ThunderSloth/kirb-3/doc/src/fig/ping_timing_diagram.png

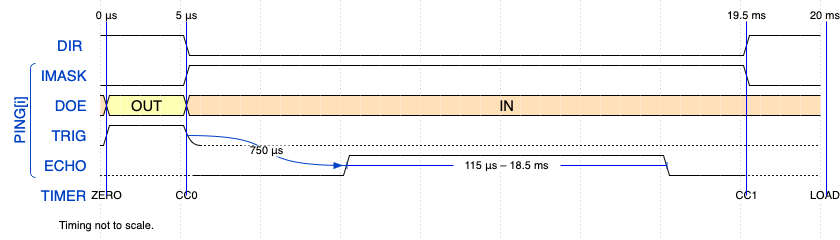
doc/src/fig/ping_timing_diagram.png
