ThunderSloth/kirb-3/resources/FS-iA6B_RC-Receiver_Specs.png

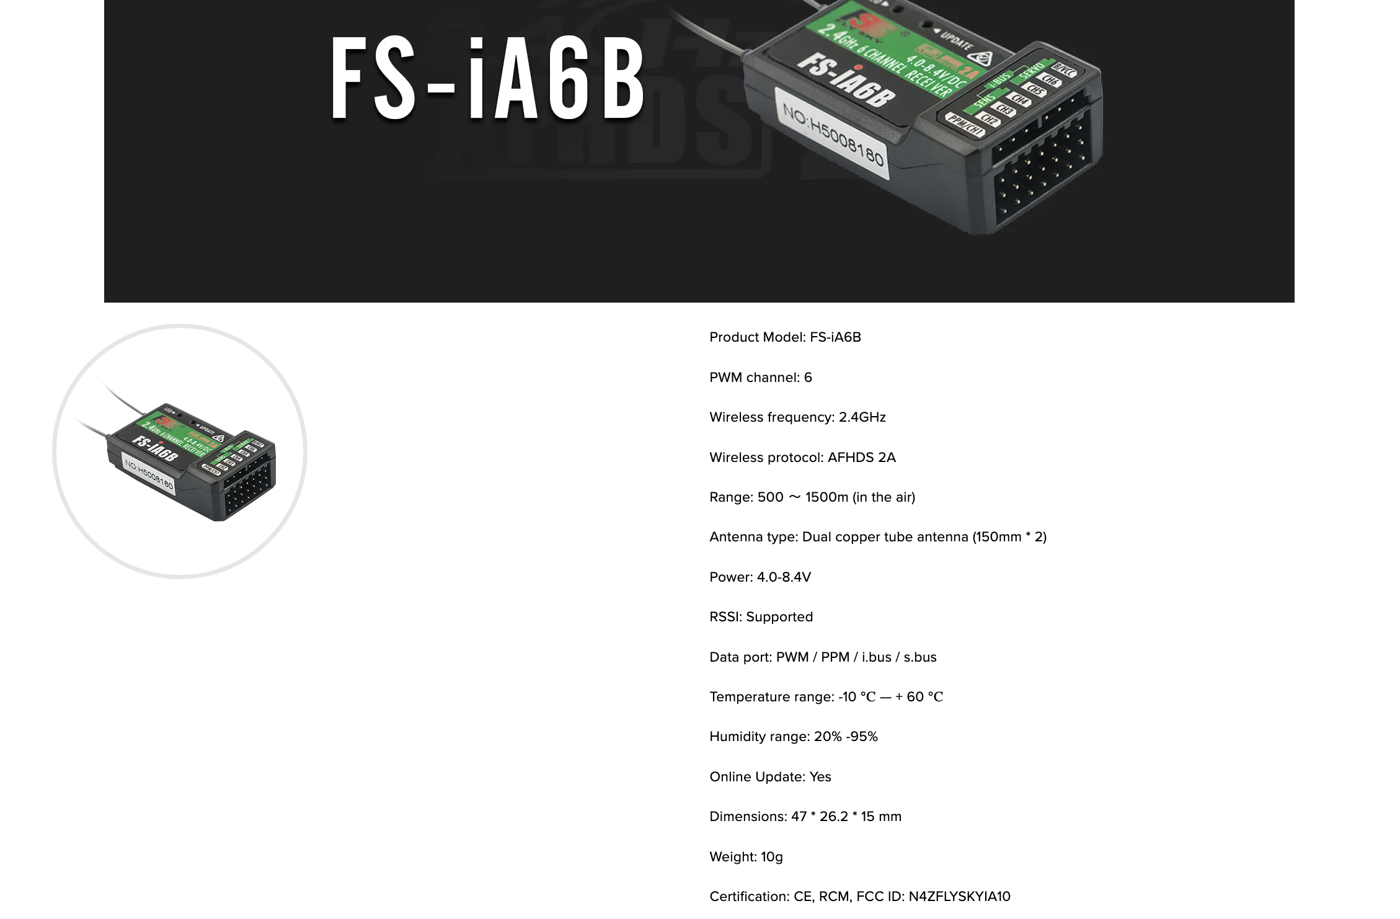
resources/FS-iA6B_RC-Receiver_Specs.png
