ThunderSloth/kirb-3/design/CameraMast.stl

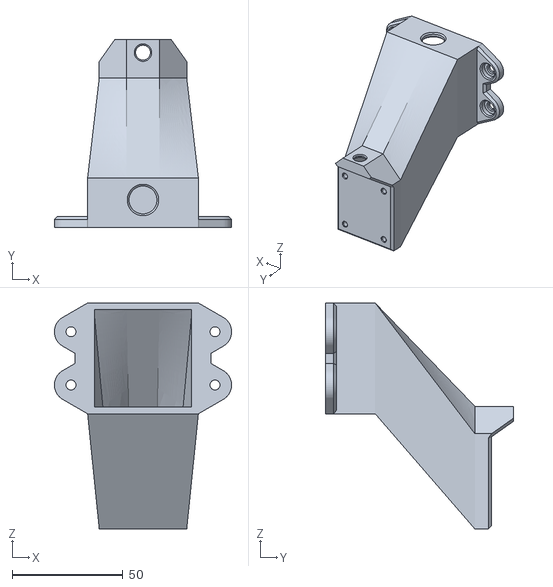
[picture p4: CAD file, 2026-05-11]
design/CameraMast.stl
80.0 x 85.0 x 102.0
