ThunderSloth/kirb-3/resources/QEI_Schematic.pdf

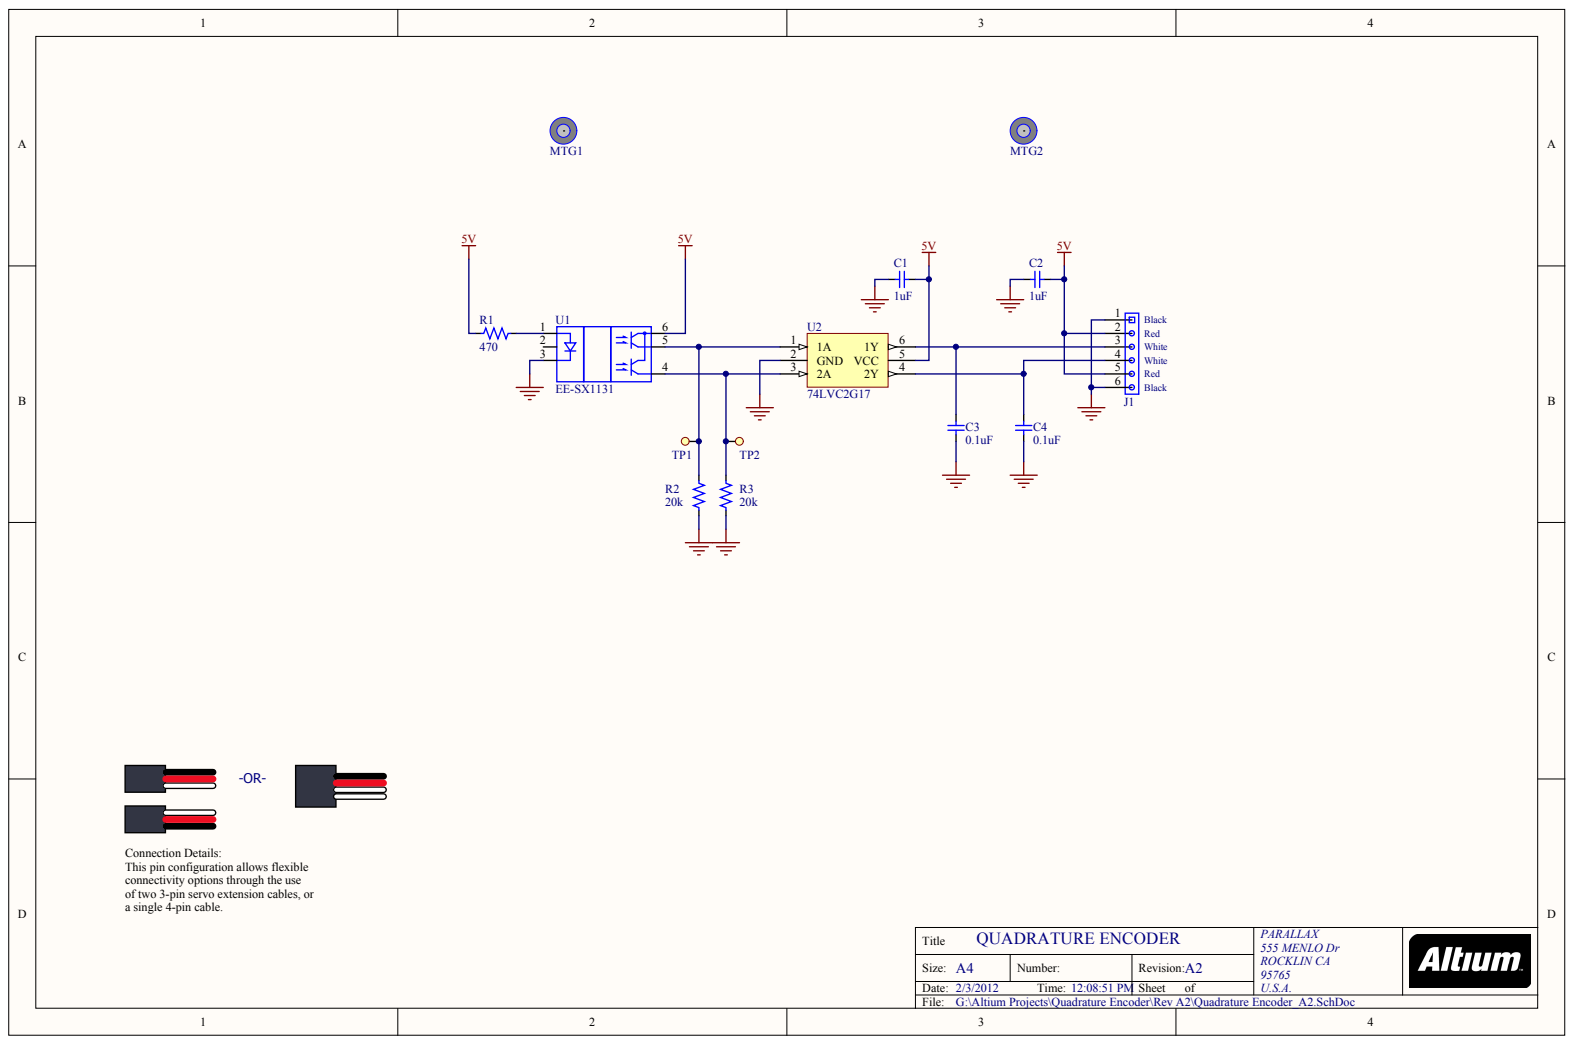
[picture p52: page 1]

Connection Details:
This pin configuration allows flexible
connectivity options through the use
of two 3-pin servo extension cables, or
a single 4-pin cable.

QUADRATURE ENCODER Title | PARALLAX 555 MENLO Dr ROCKLIN CA 95765 U.S.A.

Size: A4 | Number: | Revision: A2

Date: 2/3/2012 Time: 12:08:51 PM | | Sheet of
File: G:\Altium Projects\Quadrature Encoder\Rev A2\Quadrature Encoder_A2.SchDoc
