ThunderSloth/kirb-3/design/KIRB/LP_MSPM0G3507_HDR.kicad_sch

## KiCad design design/KIRB/LP_MSPM0G3507_HDR.kicad_sch (2026-05-11)

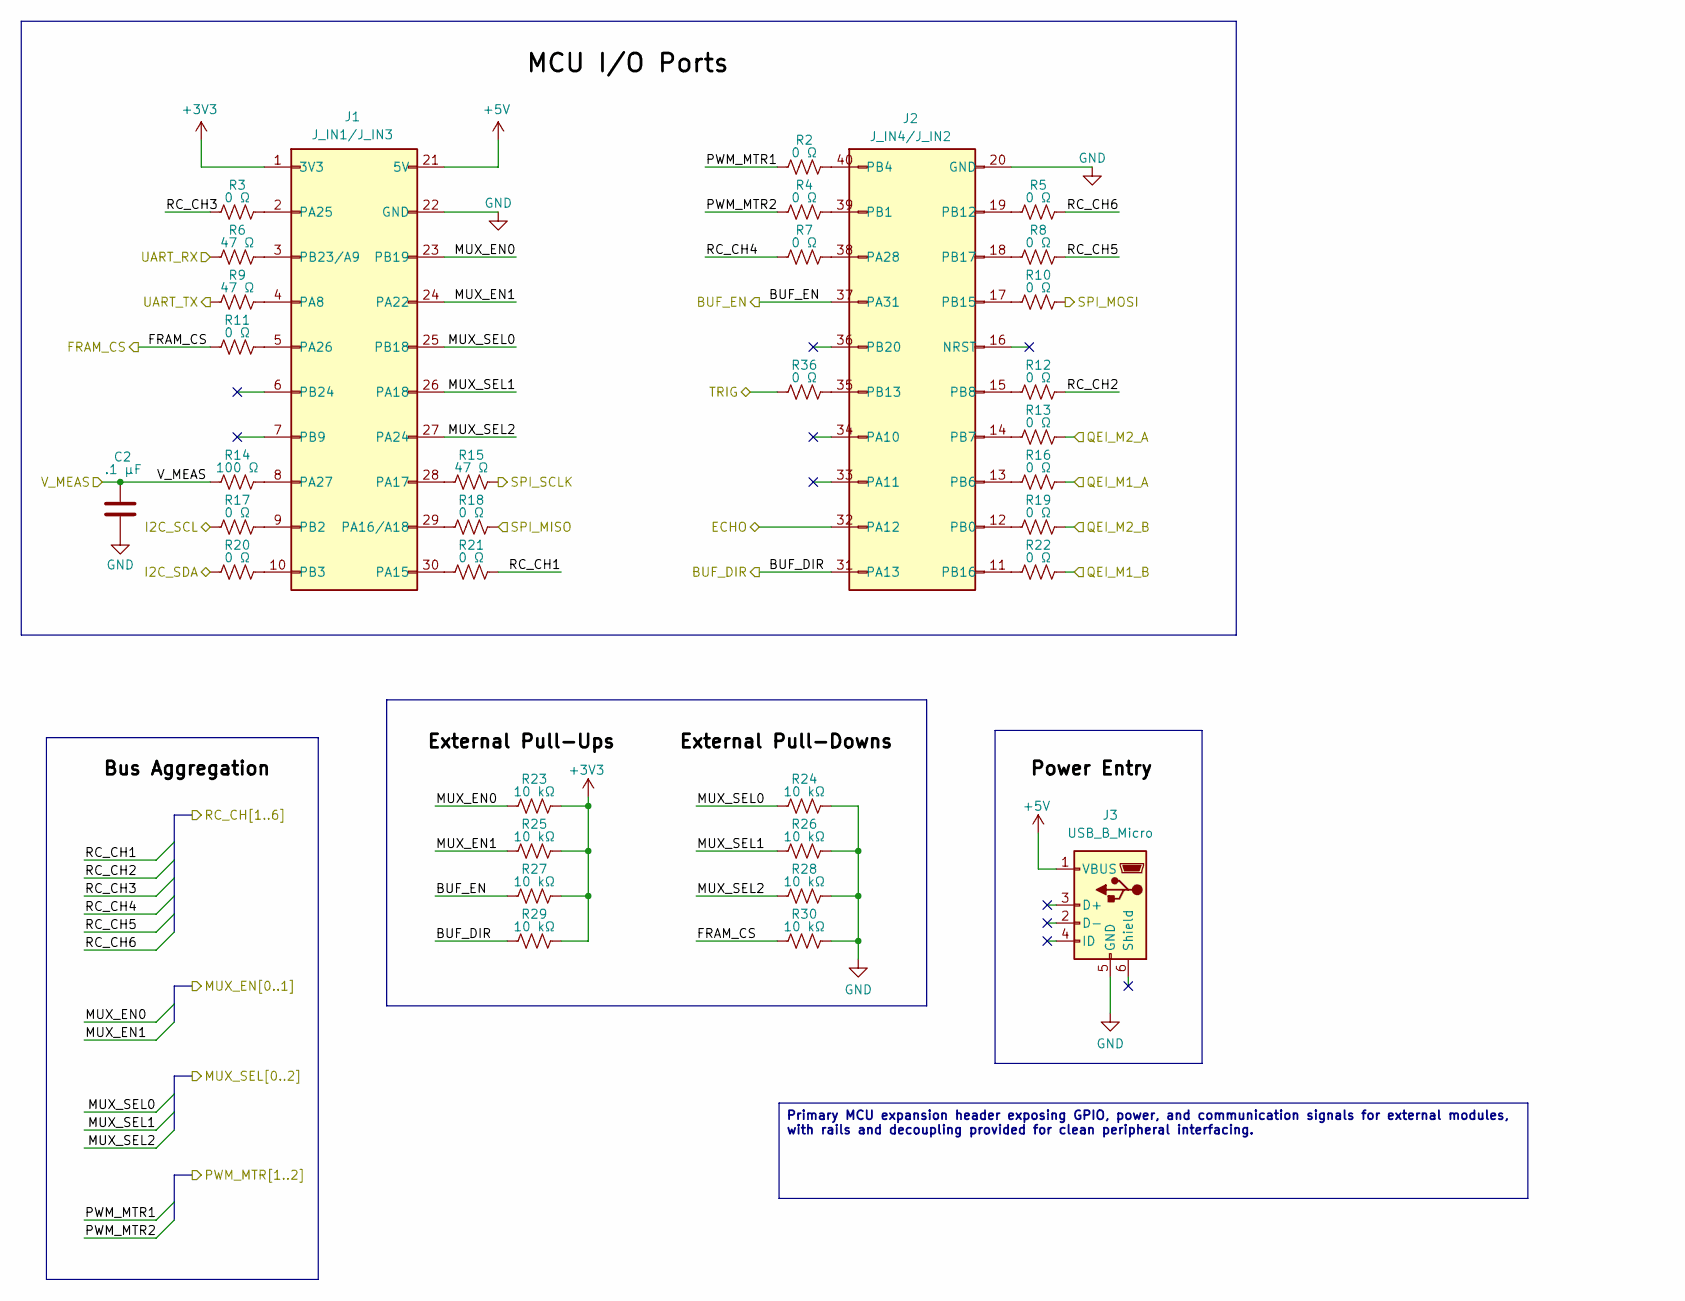
[picture p53: schematic LP_MSPM0G3507_HDR.kicad_sch]

Parts:
C2: .1 µF
J1: J_IN1/J_IN3; PinHeader_2x10_P2.54mm_Vertical
J2: J_IN4/J_IN2; PinHeader_2x10_P2.54mm_Vertical
J3: USB_B_Micro
R2, R3, R4, R5, R7, R8, R10, R11, R12, R13, R16, R17, R18, R19, R20, R21, R22, R36: 0 Ω
R6, R9, R15: 47 Ω
R14: 100 Ω
R23, R24, R25, R26, R27, R28, R29, R30: 10 kΩ

Connections:
+3V3: J1.1 (3V3), R23.2, R25.2, R27.2, R29.2
+5V: J1.21 (5V), J3.1 (VBUS)
BUF_DIR: J2.31 (PA13), R29.1
BUF_EN: J2.37 (PA31), R27.1
ECHO: J2.32 (PA12)
FRAM_CS: R11.1, R30.1
GND: C2.2, J1.22 (GND), J2.20 (GND), J3.5 (GND), R24.2, R26.2, R28.2, R30.2
I2C_SCL: R17.1
I2C_SDA: R20.1
MUX_EN0: J1.23 (PB19), R23.1
MUX_EN1: J1.24 (PA22), R25.1
MUX_SEL0: J1.25 (PB18), R24.1
MUX_SEL1: J1.26 (PA18), R26.1
MUX_SEL2: J1.27 (PA24), R28.1
unnamed: J1.2 (PA25), R3.2
unnamed: J1.3 (PB23/A9), R6.2
unnamed: J1.4 (PA8), R9.2
unnamed: J1.5 (PA26), R11.2
unnamed: J1.8 (PA27), R14.2
unnamed: J1.9 (PB2), R17.2
unnamed: J1.10 (PB3), R20.2
unnamed: J1.28 (PA17), R15.1
unnamed: J1.29 (PA16/A18), R18.1
unnamed: J1.30 (PA15), R21.1
unnamed: J2.11 (PB16), R22.1
unnamed: J2.12 (PB0), R19.1
unnamed: J2.13 (PB6), R16.1
unnamed: J2.14 (PB7), R13.1
unnamed: J2.15 (PB8), R12.1
unnamed: J2.17 (PB15), R10.1
unnamed: J2.18 (PB17), R8.1
unnamed: J2.19 (PB12), R5.1
unnamed: J2.35 (PB13), R36.2
unnamed: J2.38 (PA28), R7.2
unnamed: J2.39 (PB1), R4.2
unnamed: J2.40 (PB4), R2.2
PWM_MTR1: R2.1
PWM_MTR2: R4.1
QEI_M1_A: R16.2
QEI_M1_B: R22.2
QEI_M2_A: R13.2
QEI_M2_B: R19.2
RC_CH1: R21.2
RC_CH2: R12.2
RC_CH3: R3.1
RC_CH4: R7.1
RC_CH5: R8.2
RC_CH6: R5.2
SPI_MISO: R18.2
SPI_MOSI: R10.2
SPI_SCLK: R15.2
TRIG: R36.1
UART_RX: R6.1
UART_TX: R9.1
V_MEAS: C2.1, R14.1

Notes on the sheet:
Primary MCU expansion header exposing GPIO, power, and communication signals for external modules, with rails and decoupling provided for clean peripheral interfacing.
