ThunderSloth/kirb-3/design/KIRB/MOTOR_IF.kicad_sch

## KiCad design design/KIRB/MOTOR_IF.kicad_sch (2026-05-11)

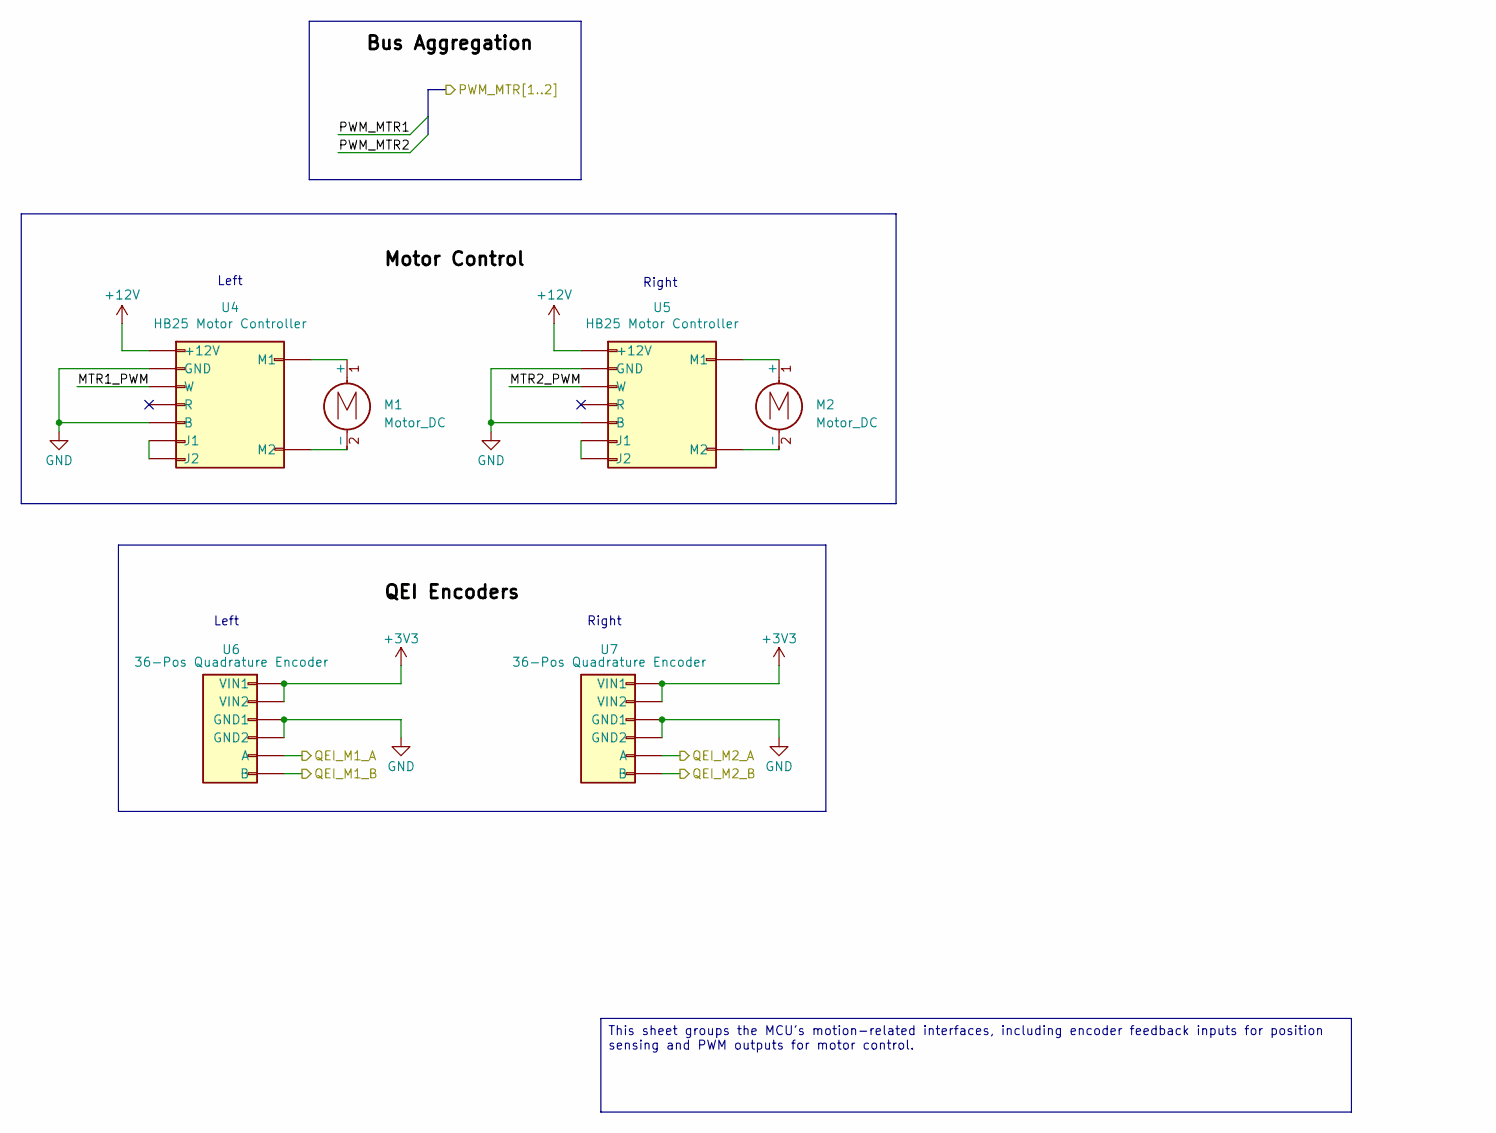
[picture p54: schematic MOTOR_IF.kicad_sch]

Parts:
M1, M2: Motor_DC
U4, U5: HB25 Motor Controller
U6, U7: 36-Pos Quadrature Encoder

Connections:
+3V3: U6.1 (VIN1), U6.2 (VIN2), U7.1 (VIN1), U7.2 (VIN2)
+12V: U4.1 (+12V), U5.1 (+12V)
GND: U4.3 (GND), U4.9 (B), U5.3 (GND), U5.9 (B), U6.3 (GND1), U6.4 (GND2), U7.3 (GND1), U7.4 (GND2)
MTR1_PWM: U4.5 (W)
MTR2_PWM: U5.5 (W)
unnamed: M1.1 (+), U4.2 (M1)
unnamed: M1.2 (-), U4.4 (M2)
unnamed: M2.1 (+), U5.2 (M1)
unnamed: M2.2 (-), U5.4 (M2)
unnamed: U4.6 (J1), U4.8 (J2)
unnamed: U5.6 (J1), U5.8 (J2)
QEI_M1_A: U6.5 (A)
QEI_M1_B: U6.6 (B)
QEI_M2_A: U7.5 (A)
QEI_M2_B: U7.6 (B)

Notes on the sheet:
Right
Left
This sheet groups the MCU's motion-related interfaces, including encoder feedback inputs for position sensing and PWM outputs for motor control.
