ThunderSloth/kirb-3/design/KIRB/POWER.kicad_sch

## KiCad design design/KIRB/POWER.kicad_sch (2026-05-11)

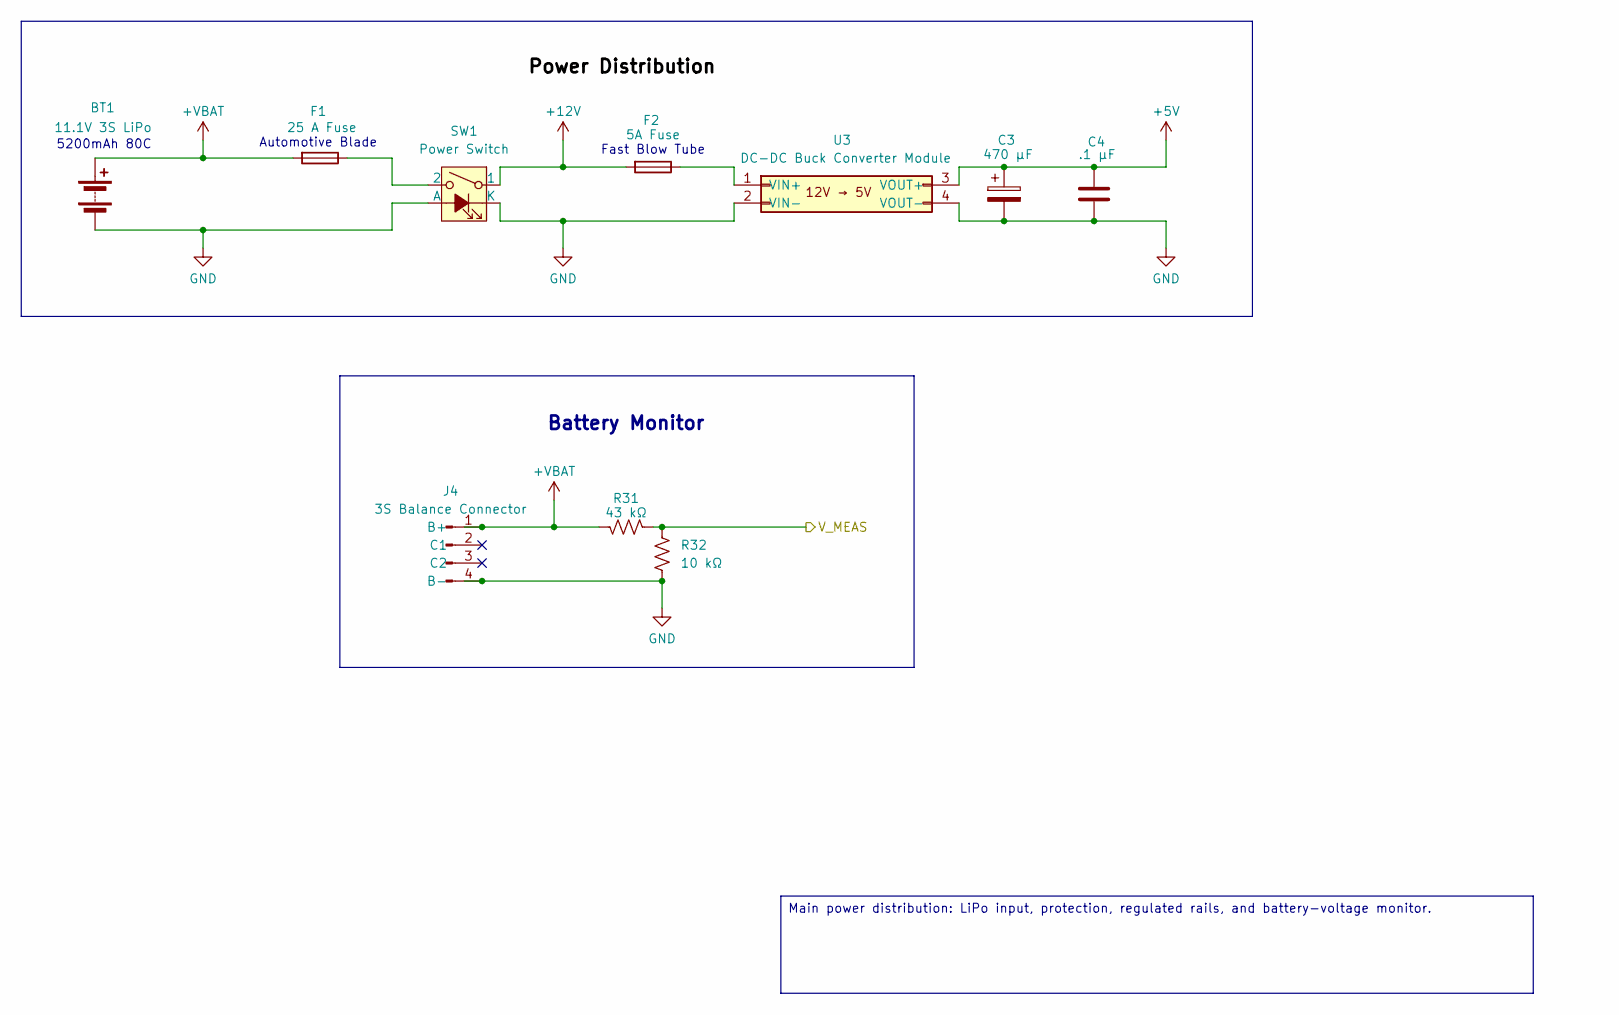
[picture p55: schematic POWER.kicad_sch]

Parts:
BT1: 11.1V 3S LiPo
C3: 470 µF
C4: .1 µF
F1: 25 A Fuse
F2: 5A Fuse
J4: 3S Balance Connector
R31: 43 kΩ
R32: 10 kΩ
SW1: Power Switch
U3: DC-DC Buck Converter Module

Connections:
+5V: C3.1, C4.1, U3.3 (VOUT+)
+12V: F2.2, SW1.1
+VBAT: BT1.1 (+), F1.2, J4.1 (B+), R31.1
GND: BT1.2 (-), C3.2, C4.2, J4.4 (B-), R32.2, SW1.3 (K), SW1.4 (A), U3.2 (VIN-), U3.4 (VOUT-)
unnamed: F1.1, SW1.2
unnamed: F2.1, U3.1 (VIN+)
V_MEAS: R31.2, R32.1

Notes on the sheet:
Fast Blow Tube
5200mAh 80C
Battery Monitor
Automotive Blade
Main power distribution: LiPo input, protection, regulated rails, and battery-voltage monitor.
