ThunderSloth/kirb-3/design/KIRB/RC_RECV_IF.kicad_sch

## KiCad design design/KIRB/RC_RECV_IF.kicad_sch (2026-05-11)

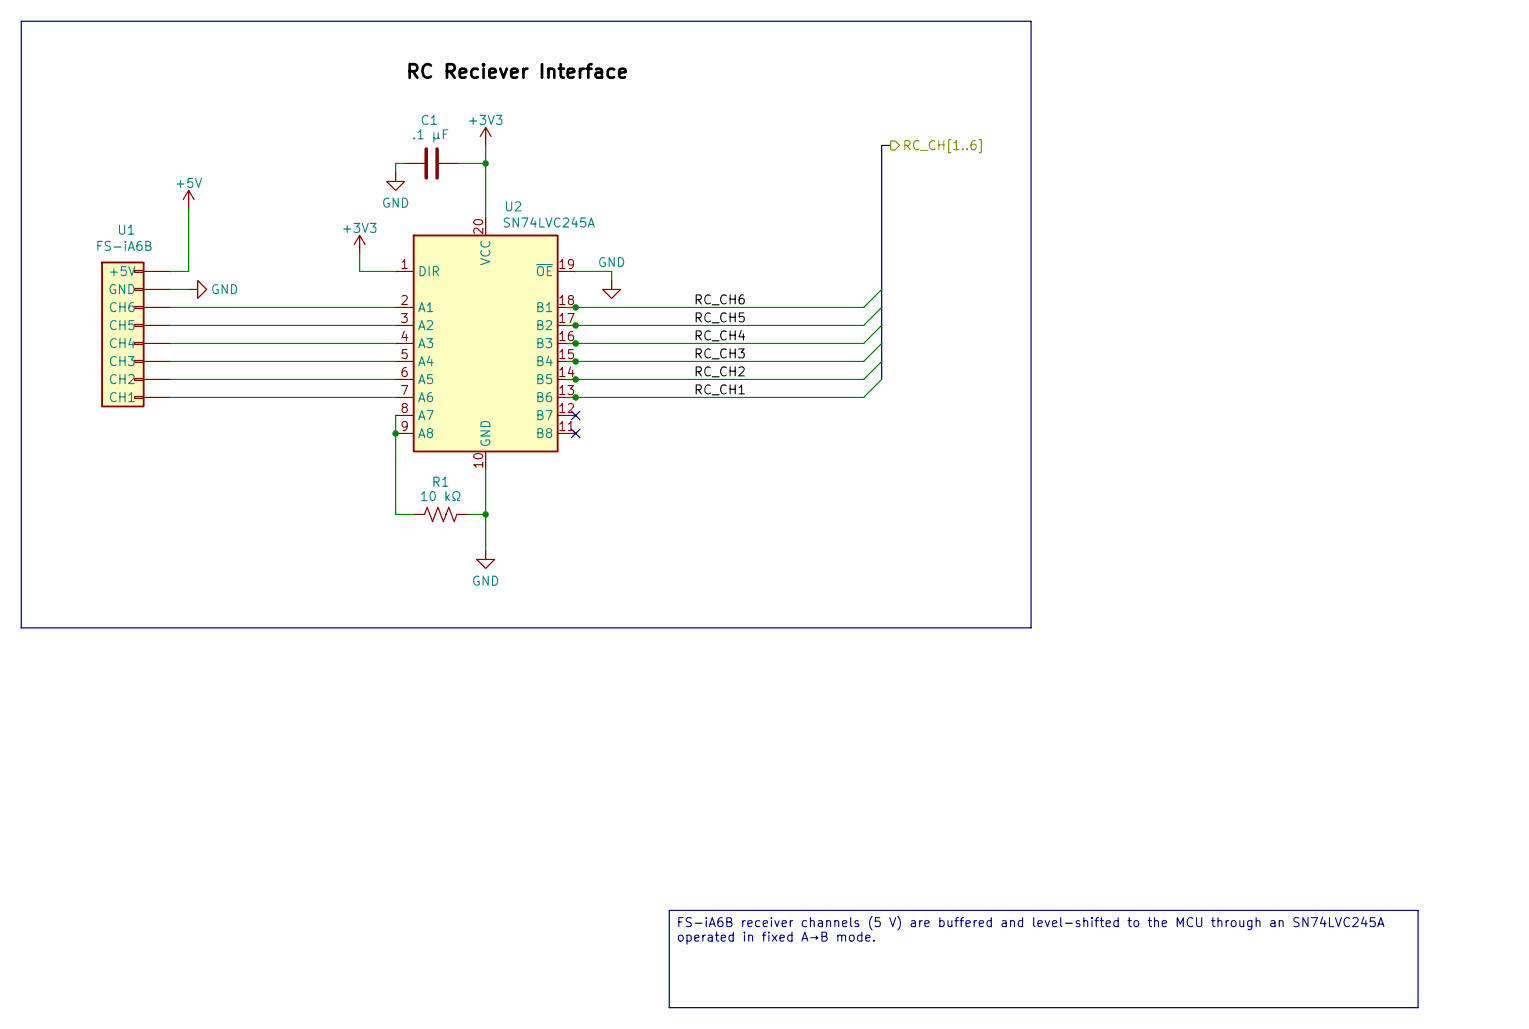
[picture p56: schematic RC_RECV_IF.kicad_sch]

Parts:
C1: .1 µF
R1: 10 kΩ
U1: FS-iA6B
U2: SN74LVC245A; TSSOP-20_4.4x6.5mm_P0.65mm

Connections:
+3V3: C1.2, U2.1 (DIR), U2.20 (VCC)
+5V: U1.1 (+5V)
GND: C1.1, R1.1, U1.2 (GND), U2.10 (GND), U2.19 (~OE)
unnamed: R1.2, U2.8 (A7), U2.9 (A8)
unnamed: U1.3 (CH6), U2.2 (A1)
unnamed: U1.4 (CH5), U2.3 (A2)
unnamed: U1.5 (CH4), U2.4 (A3)
unnamed: U1.6 (CH3), U2.5 (A4)
unnamed: U1.7 (CH2), U2.6 (A5)
unnamed: U1.8 (CH1), U2.7 (A6)
RC_CH1: U2.13 (B6)
RC_CH2: U2.14 (B5)
RC_CH3: U2.15 (B4)
RC_CH4: U2.16 (B3)
RC_CH5: U2.17 (B2)
RC_CH6: U2.18 (B1)

Notes on the sheet:
FS-iA6B receiver channels (5 V) are buffered and level-shifted to the MCU through an SN74LVC245A operated in fixed A→B mode.
