ThunderSloth/kirb-3/design/KIRB/ULTRASONICS.kicad_sch

## KiCad design design/KIRB/ULTRASONICS.kicad_sch (2026-05-11)

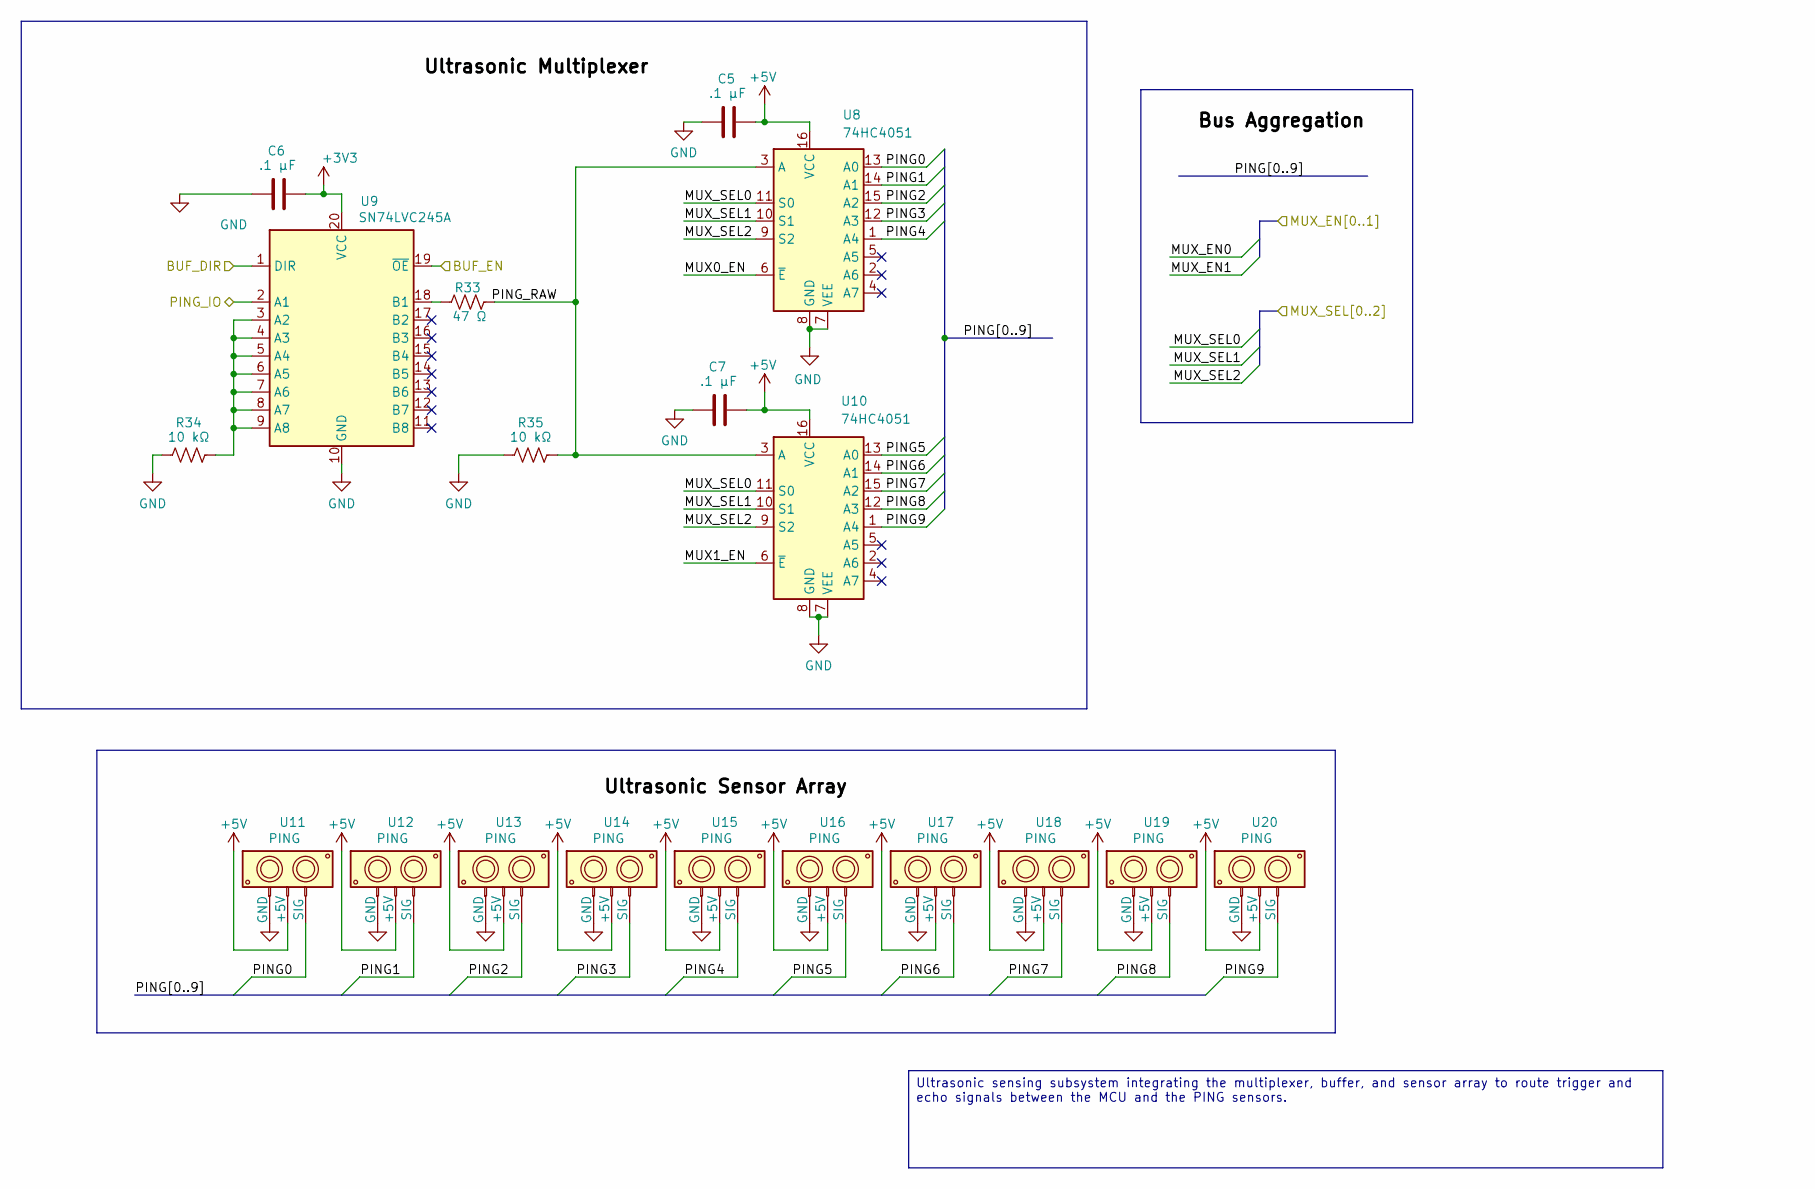
[picture p57: schematic ULTRASONICS.kicad_sch]

Parts:
C5, C6, C7: .1 µF
R33: 47 Ω
R34, R35: 10 kΩ
U8, U10: 74HC4051
U9: SN74LVC245A; TSSOP-20_4.4x6.5mm_P0.65mm
U11, U12, U13, U14, U15, U16, U17, U18, U19, U20: PING

Connections:
+3V3: C6.2, U9.20 (VCC)
+5V: C5.2, C7.2, U8.16 (VCC), U10.16 (VCC), U11.2 (+5V), U12.2 (+5V), U13.2 (+5V), U14.2 (+5V), U15.2 (+5V), U16.2 (+5V), U17.2 (+5V), U18.2 (+5V), U19.2 (+5V), U20.2 (+5V)
BUF_DIR: U9.1 (DIR)
BUF_EN: U9.19 (~OE)
GND: C5.1, C6.1, C7.1, R34.2, R35.2, U8.7 (VEE), U8.8 (GND), U9.10 (GND), U10.7 (VEE), U10.8 (GND), U11.1 (GND), U12.1 (GND), U13.1 (GND), U14.1 (GND), U15.1 (GND), U16.1 (GND), U17.1 (GND), U18.1 (GND), U19.1 (GND), U20.1 (GND)
MUX0_EN: U8.6 (~E)
MUX1_EN: U10.6 (~E)
MUX_SEL0: U8.11 (S0), U10.11 (S0)
MUX_SEL1: U8.10 (S1), U10.10 (S1)
MUX_SEL2: U8.9 (S2), U10.9 (S2)
unnamed: R33.2, U9.18 (B1)
unnamed: R34.1, U9.3 (A2), U9.4 (A3), U9.5 (A4), U9.6 (A5), U9.7 (A6), U9.8 (A7), U9.9 (A8)
PING0: U8.13 (A0), U11.3 (SIG)
PING1: U8.14 (A1), U12.3 (SIG)
PING2: U8.15 (A2), U13.3 (SIG)
PING3: U8.12 (A3), U14.3 (SIG)
PING4: U8.1 (A4), U15.3 (SIG)
PING5: U10.13 (A0), U16.3 (SIG)
PING6: U10.14 (A1), U17.3 (SIG)
PING7: U10.15 (A2), U18.3 (SIG)
PING8: U10.12 (A3), U19.3 (SIG)
PING9: U10.1 (A4), U20.3 (SIG)
PING_IO: U9.2 (A1)
PING_RAW: R33.1, R35.1, U8.3 (A), U10.3 (A)

Notes on the sheet:
Ultrasonic sensing subsystem integrating the multiplexer, buffer, and sensor array to route trigger and echo signals between the MCU and the PING sensors.
