ThunderSloth/kirb-3/(commit log)

2025-11-20 robot is mobile
    [RoverBasePlate.step]
2025-11-20 added example path to timer.c
2025-11-20 Power init funtion working
2025-11-25 ult doc
    [KIRB.kicad_pcb, KIRB.kicad_sch]
2025-11-25 pwm steps
2025-11-25 pwm progress
2025-11-25 removed clock prototype
2025-11-26 completed converting sysconfig from driverlib to low level c and refactored
    [KIRB.kicad_sch]
2025-12-01 kicad system block diagram and pin reassignment
    [KIRB.kicad_sch, LP_MSPM0G3507_HDR.kicad_sch, MOTOR_IF.kicad_sch, POWER.kicad_sch, RC_RECV_IF.kicad_sch, ULTRASONICS.kicad_sch]
2025-12-02 started ult software
    [LP_MSPM0G3507_HDR.kicad_sch, MOTOR_IF.kicad_sch, POWER.kicad_sch, RC_RECV_IF.kicad_sch, ULTRASONICS.kicad_sch]
2025-12-03 update ult flow chart, lay down ult skeleton in code, renamed resource white papers
    [KIRB.kicad_sch, LP_MSPM0G3507_HDR.kicad_sch, MOTOR_IF.kicad_sch, POWER.kicad_sch, RC_RECV_IF.kicad_sch, RoverBasePlate.step, ULTRASONICS.kicad_sch]
2025-12-03 Backup working tree before syncing with origin/main
    [KIRB.kicad_sch, LP_MSPM0G3507_HDR.kicad_sch, MOTOR_IF.kicad_sch, POWER.kicad_sch, RC_RECV_IF.kicad_sch, RoverBasePlate.step, ULTRASONICS.kicad_sch]
2025-12-03 Remove duplicate '* 2.*' backup files
    [KIRB 2.kicad_sch, LP_MSPM0G3507_HDR 2.kicad_sch, MOTOR_IF 2.kicad_sch, POWER 2.kicad_sch, RC_RECV_IF 2.kicad_sch, RoverBasePlate 2.step, ULTRASONICS 2.kicad_sch]
2025-12-04 Added function to controll minor diff in motor speeds
2025-12-04 started implementing uart
2025-12-04 Added functions that convert data for UART
2025-12-04 Moved UART functions into the UART files
2025-12-04 Translated the get pending interrupt functions in the switch statments
2025-12-04 Translated get timer count function from dl
2025-12-09 moved servo pulse symbols to motor.h
2025-12-10 added ultrasonic stuff
2025-12-10 edited buzzer pin lines in systick
2026-02-16 added kirb3 graphic
    [LP_MSPM0G3507_HDR.kicad_sch]
2026-05-11 Add ESP32 bridge and camera firmware
    [partitions.csv]
2026-05-11 remove obsolete files
    [CameraMast.stl, LP_MSPM0G3507_HDR.kicad_sch, MOTOR_IF.kicad_sch, POWER.kicad_sch, RC_RECV_IF.kicad_sch, ULTRASONICS.kicad_sch]
